rsurya07/ECE411/SmartThermo2.1.brd

## EAGLE design SmartThermo2.1.brd (2017-12-07)

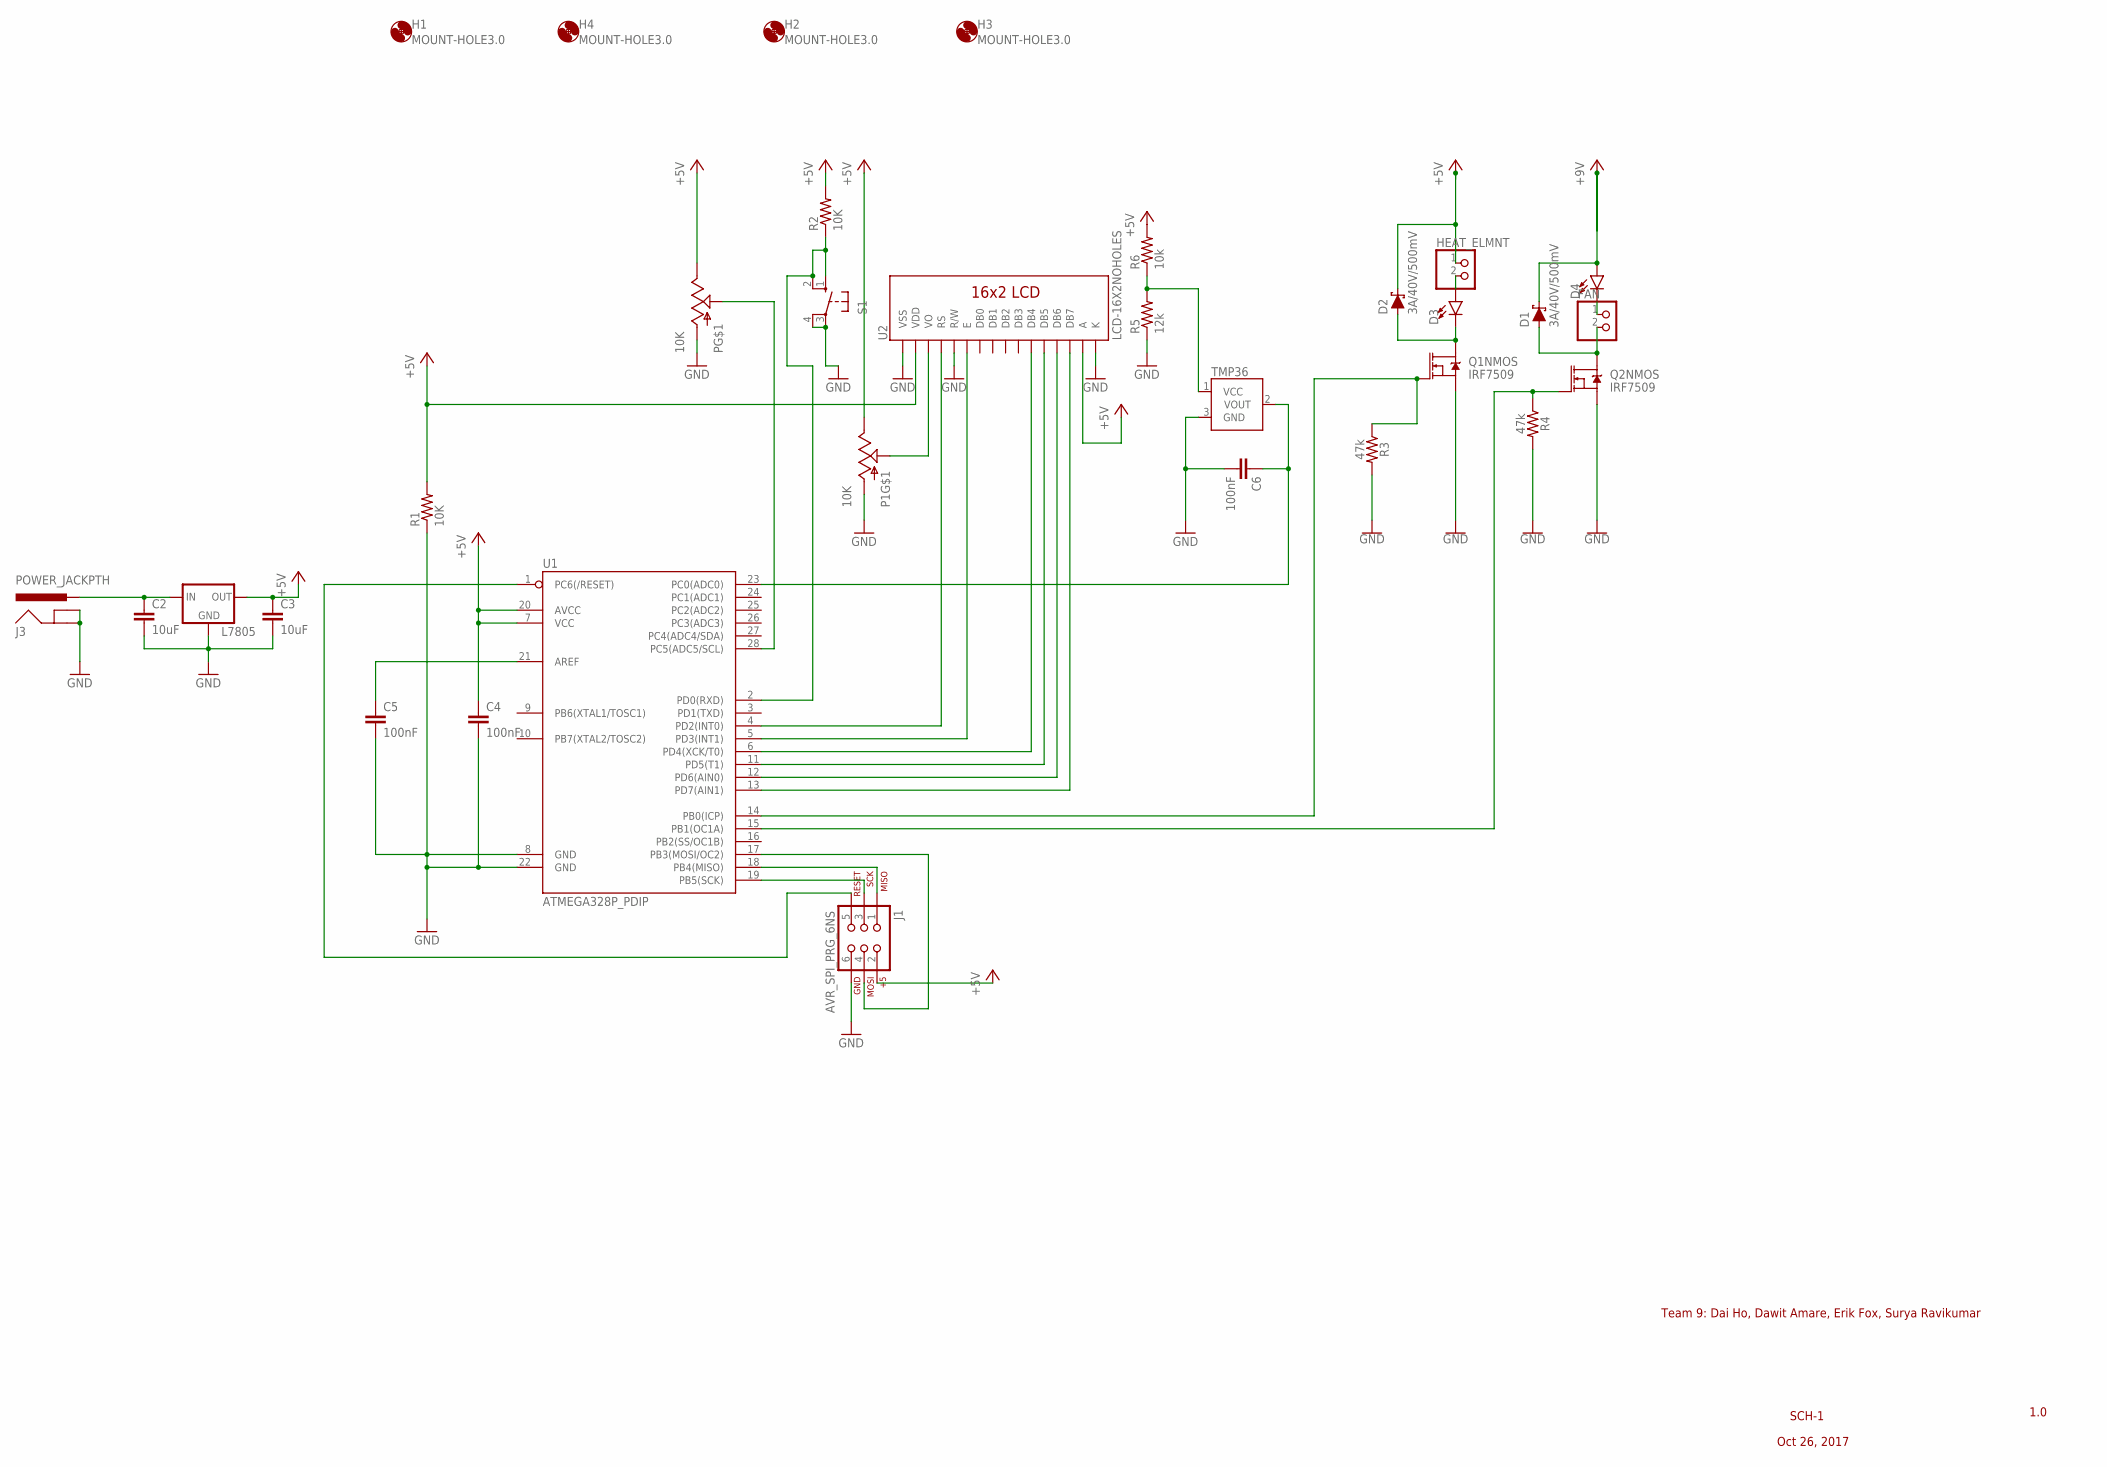
[picture p1: schematic SmartThermo2.1.sch]

Parts:
C2, C3: 10uF; C7.5B3
C4, C5, C6: 100nF; C2.5-2
D1, D2: 3A/40V/500mV; SMA-DIODE
D3, D4: LED3MM; LED_3MM
FAN: PINHD-1X2/90; 1X02/90
H1, H2, H3, H4: MOUNT-HOLE3.0; 3,0
HEAT_ELMNT: PINHD-1X2/90; 1X02/90
J1: AVR_SPI_PRG_6NS; 2X3-NS
J3: POWER_JACKPTH; POWER_JACK_PTH
L7805: 78XXL
P, P1: 10K; POT_PTH
Q1, Q2: IRF7509; MSOP8
R1, R2: 10K; 1206
R3, R4: 47k; 0603
R5: 12k; 0204/5
R6: 10k; 0204/5
S1: 10-XX; B3F-10XX
TMP36: TMP36GT9; TO-92
U1: ATMEGA328P_PDIP; DIL28-3
U2: LCD-16X2NOHOLES; LCD-16X2_NOHOLES

Connections:
+5V: C3.1, C4.1, D1.C, D2.C, D4.A, HEAT_ELMNT.1, J1.2, L7805.OUT, P.E@2 (E), P1.E@2 (E), R1.2, R2.2, R6.2, U1.7 (VCC), U1.20 (AVCC), U2.2 (VDD), U2.15 (A)
GND: C2.2, C3.2, C4.2, C5.2, C6.2, J1.6, J3.GND, J3.GNDBREAK, L7805.GND, P.E@1 (A), P1.E@1 (A), Q1.1 (S), Q2.1 (S), R1.1, R3.2, R4.2, R5.1, S1.3, S1.4 (P1), TMP36.3 (GND), U1.8 (GND), U1.22 (GND), U2.1 (VSS), U2.5 (R/W), U2.16 (K)
unnamed: C6.1, TMP36.2 (VOUT), U1.23 (PC0(ADC0))
unnamed: P.WAND (S), U1.28 (PC5(ADC5/SCL))
unnamed: Q2.2 (G), R4.1, U1.15 (PB1(OC1A))
unnamed: U1.4 (PD2(INT0)), U2.4 (RS)
unnamed: P1.WAND (S), U2.3 (VO)
unnamed: U1.5 (PD3(INT1)), U2.6 (E)
unnamed: U1.6 (PD4(XCK/T0)), U2.11 (DB4)
unnamed: U1.11 (PD5(T1)), U2.12 (DB5)
unnamed: U1.12 (PD6(AIN0)), U2.13 (DB6)
unnamed: U1.13 (PD7(AIN1)), U2.14 (DB7)
unnamed: C2.1, J3.PWR, L7805.IN
unnamed: D1.A, FAN.2, Q2.7 (D), Q2.8 (D)
unnamed: R5.2, R6.1, TMP36.1 (VCC)
unnamed: R2.1, S1.1 (S), S1.2 (S1), U1.2 (PD0(RXD))
unnamed: J1.1, U1.18 (PB4(MISO))
unnamed: D3.A, HEAT_ELMNT.2
unnamed: J1.4, U1.17 (PB3(MOSI/OC2))
unnamed: Q1.2 (G), R3.1, U1.14 (PB0(ICP))
unnamed: J1.3, U1.19 (PB5(SCK))
unnamed: D2.A, D3.K (C), Q1.7 (D), Q1.8 (D)
unnamed: D4.K (C), FAN.1
unnamed: C5.1, U1.21 (AREF)
unnamed: J1.5, U1.1 (PC6(/RESET))

Notes on the sheet:
Team 9: Dai Ho, Dawit Amare, Erik Fox, Surya Ravikumar
1.0
SCH-1
Oct 26, 2017

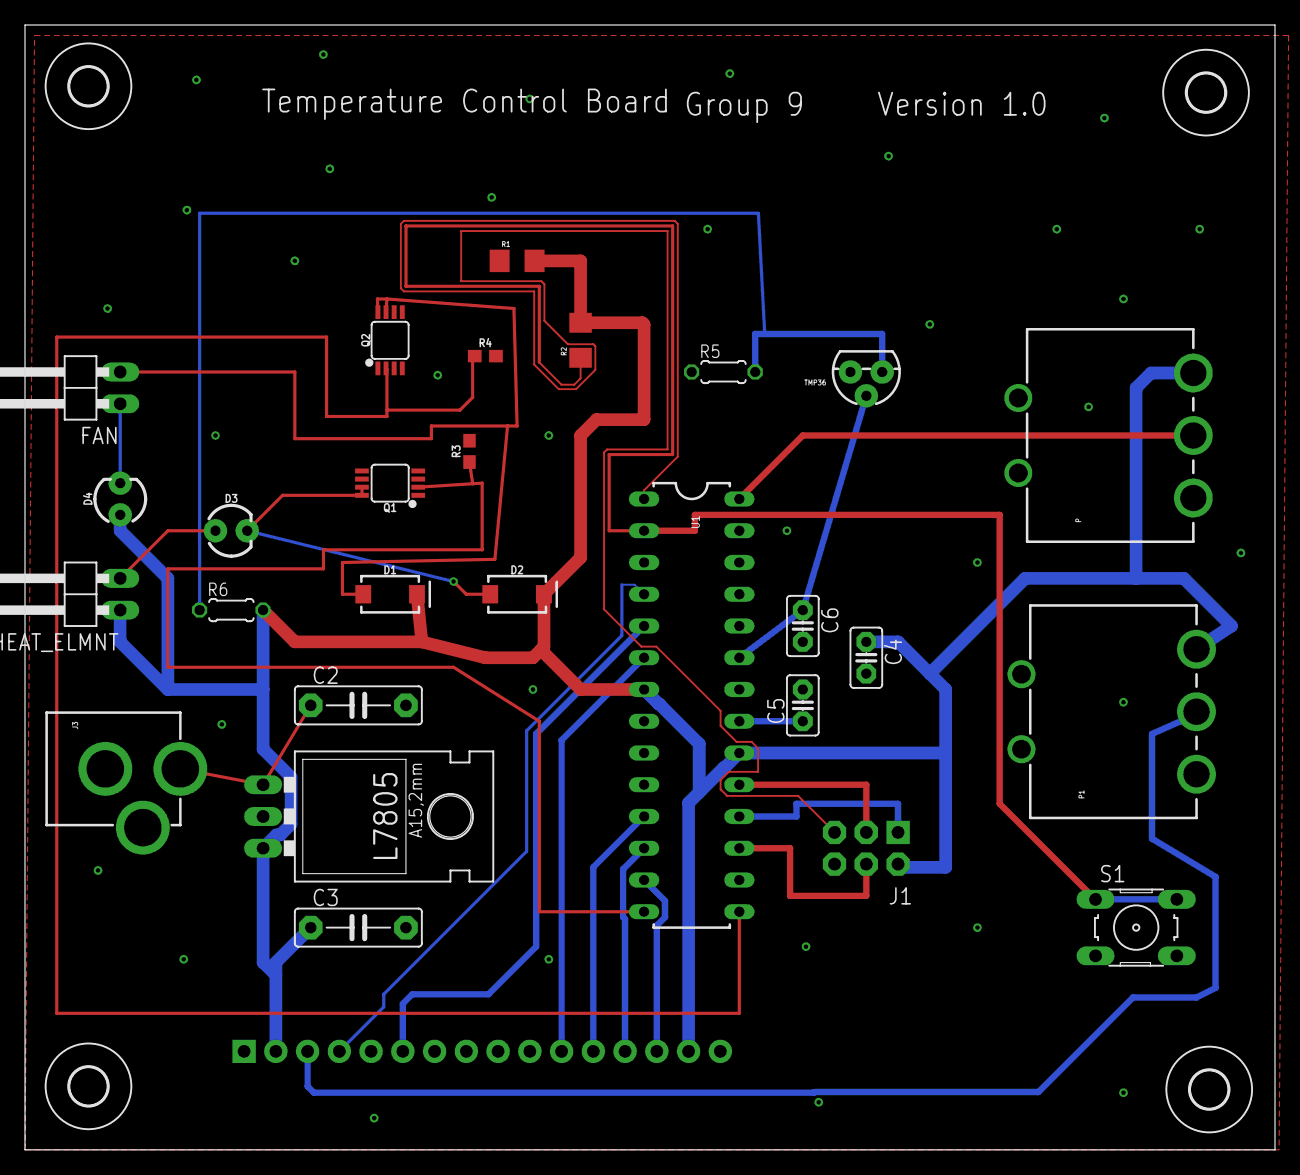
[picture p2: board SmartThermo2.1.brd from above]

Board: 2 copper layers, 100.0 x 90.0 mm, 32 parts (0 on the bottom side), 25 nets.
