rsurya07/ECE411/(commit log)

2017-11-18 Create Button-Toggle-AUTO-ON_OFF.c
    This toggles Auto on or off. On Auto off, Potentiometer needs to be activated and LCD should display value. Once value sets, use it to adjust temperature.
2017-11-29 Update this file
    Code including all parts: LCD, Heating, Cooling, and LEDs. update this code moving forward
